Goodacre-Querengesser/garbox/garbox.kicad_pcb

## KiCad design garbox.kicad_pcb (2025-11-29)

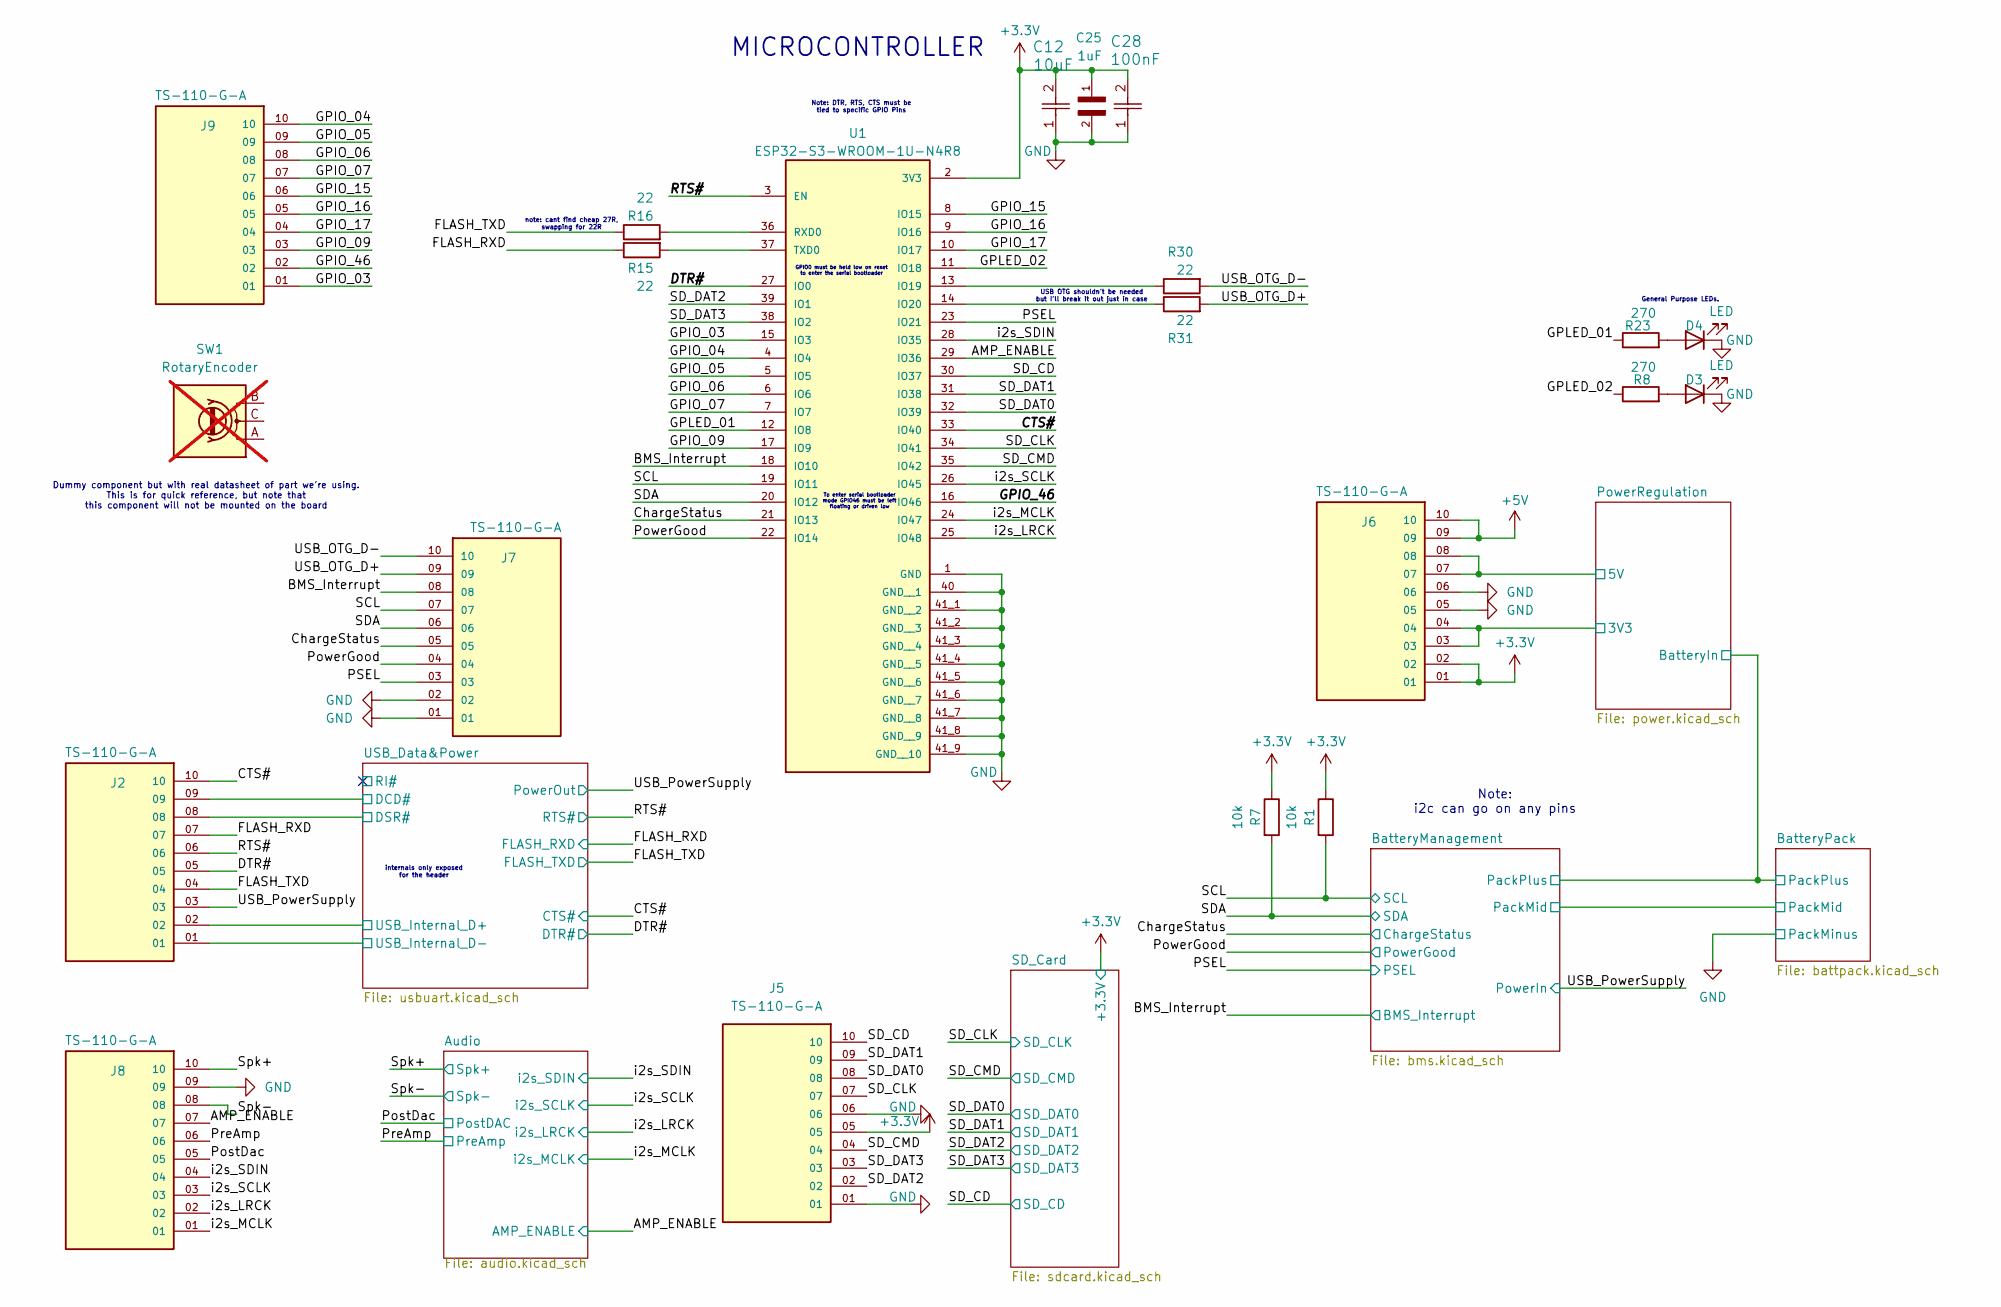
[picture p1: schematic garbox.kicad_sch]

Parts:
C12: 10uF; CAP_CL31_SAM; MPN C13585
C25: 1uF; CAPC3216X180N; MPN C1848
C28: 100nF; CAPC1005X55N; MPN C1525
D3, D4: LED; LED_0201_0603Metric; MPN C2286
J2, J5, J6, J7, J8, J9: TS-110-G-A; SAMTEC_TS-110-G-A; PARTREV R
R1, R7: 10k; R_0201_0603Metric; MPN C25804
R8, R23: 270; R_0201_0603Metric; MPN C22966
R15, R16, R30, R31: 22; R_0201_0603Metric; MPN C23345
SW1: RotaryEncoder; RotaryEncoder_Bourns_Horizontal_PEC09-2xxxF-Nxxxx; MPN C143788; not fitted
U1: ESP32-S3-WROOM-1U-N4R8; XCVR_ESP32-S3-WROOM-1U-N4R8; PARTREV v1.1

Connections:
+3.3V: C12.2, C25.1, C28.2, J5.05, J6.01, J6.02, R1.1, R7.1, U1.2 (3V3); also elsewhere on the board
+5V: J6.09, J6.10; also elsewhere on the board
/AMP_ENABLE: J8.07, U1.29 (IO36); also elsewhere on the board
/BMS_Interrupt: J7.08, U1.18 (IO10); also elsewhere on the board
/CTS#: J2.10, U1.33 (IO40); also elsewhere on the board
/ChargeStatus: J7.05, U1.21 (IO13); also elsewhere on the board
/DTR#: J2.05, U1.27 (IO0); also elsewhere on the board
/FLASH_RXD: J2.07, R15.1; also elsewhere on the board
/FLASH_TXD: J2.04, R16.1; also elsewhere on the board
/GPIO_03: J9.01, U1.15 (IO3)
/GPIO_04: J9.10, U1.4 (IO4)
/GPIO_05: J9.09, U1.5 (IO5)
/GPIO_06: J9.08, U1.6 (IO6)
/GPIO_07: J9.07, U1.7 (IO7)
/GPIO_09: J9.03, U1.17 (IO9)
/GPIO_15: J9.06, U1.8 (IO15)
/GPIO_16: J9.05, U1.9 (IO16)
/GPIO_17: J9.04, U1.10 (IO17)
/GPIO_46: J9.02, U1.16 (IO46)
/GPLED_01: R23.1, U1.12 (IO8)
/GPLED_02: R8.1, U1.11 (IO18)
/PSEL: J7.03, U1.23 (IO21); also elsewhere on the board
/PostDac: J8.05; also elsewhere on the board
/PowerGood: J7.04, U1.22 (IO14); also elsewhere on the board
/PowerRegulation/3V3: J6.03, J6.04; also elsewhere on the board
/PowerRegulation/5V: J6.07, J6.08; also elsewhere on the board
/PreAmp: J8.06; also elsewhere on the board
/RTS#: J2.06, U1.3 (EN); also elsewhere on the board
/SCL: J7.07, R1.2, U1.19 (IO11); also elsewhere on the board
/SDA: J7.06, R7.2, U1.20 (IO12); also elsewhere on the board
/SD_CD: J5.10, U1.30 (IO37); also elsewhere on the board
/SD_CLK: J5.07, U1.34 (IO41); also elsewhere on the board
/SD_CMD: J5.04, U1.35 (IO42); also elsewhere on the board
/SD_DAT0: J5.08, U1.32 (IO39); also elsewhere on the board
/SD_DAT1: J5.09, U1.31 (IO38); also elsewhere on the board
/SD_DAT2: J5.02, U1.39 (IO1); also elsewhere on the board
/SD_DAT3: J5.03, U1.38 (IO2); also elsewhere on the board
/Spk+: J8.10; also elsewhere on the board
/Spk-: J8.08; also elsewhere on the board
/USB_Data&Power/DCD#: J2.09; also elsewhere on the board
/USB_Data&Power/DSR#: J2.08; also elsewhere on the board
/USB_Data&Power/USB_D+: J2.02; also elsewhere on the board
/USB_Data&Power/USB_D-: J2.01; also elsewhere on the board
/USB_OTG_D+: J7.09, R31.2
/USB_OTG_D-: J7.10, R30.2
/USB_PowerSupply: J2.03; also elsewhere on the board
/i2s_LRCK: J8.02, U1.25 (IO48); also elsewhere on the board
/i2s_MCLK: J8.01, U1.24 (IO47); also elsewhere on the board
/i2s_SCLK: J8.03, U1.26 (IO45); also elsewhere on the board
/i2s_SDIN: J8.04, U1.28 (IO35); also elsewhere on the board
GND: C12.1, C25.2, C28.1, D3.1 (K), D4.1 (K), J5.01, J5.06, J6.05, J6.06, J7.01, J7.02, J8.09, U1.1 (GND), U1.40 (GND__1), U1.41_1 (GND__2), U1.41_2 (GND__3), U1.41_3 (GND__4), U1.41_4 (GND__5), U1.41_5 (GND__6), U1.41_6 (GND__7), U1.41_7 (GND__8), U1.41_8 (GND__9), U1.41_9 (GND__10), U1.41_10, U1.41_11, U1.41_12, U1.41_13, U1.41_14, U1.41_15, U1.41_16, U1.41_17, U1.41_18, U1.41_19, U1.41_20, U1.41_21; also elsewhere on the board
unnamed: D3.2 (A), R8.2
unnamed: D4.2 (A), R23.2
unnamed: R30.1, U1.13 (IO19)
unnamed: R31.1, U1.14 (IO20)
unnamed: R16.2, U1.36 (RXD0)
unnamed: R15.2, U1.37 (TXD0)

Notes on the sheet:
GPIO0 must be held low on reset to enter the serial bootloader
Note: DTR, RTS, CTS must be tied to specific GPIO Pins
internals only exposed for the header
note: cant find cheap 27R, swapping for 22R
Dummy component but with real datasheet of part we're using. This is for quick reference, but note that this component will not be mounted on the board
MICROCONTROLLER
Note: i2c can go on any pins
To enter serial bootloader mode GPIO46 must be left floating or driven low
USB OTG shouldn't be needed but I'll break it out just in case
General Purpose LEDs.

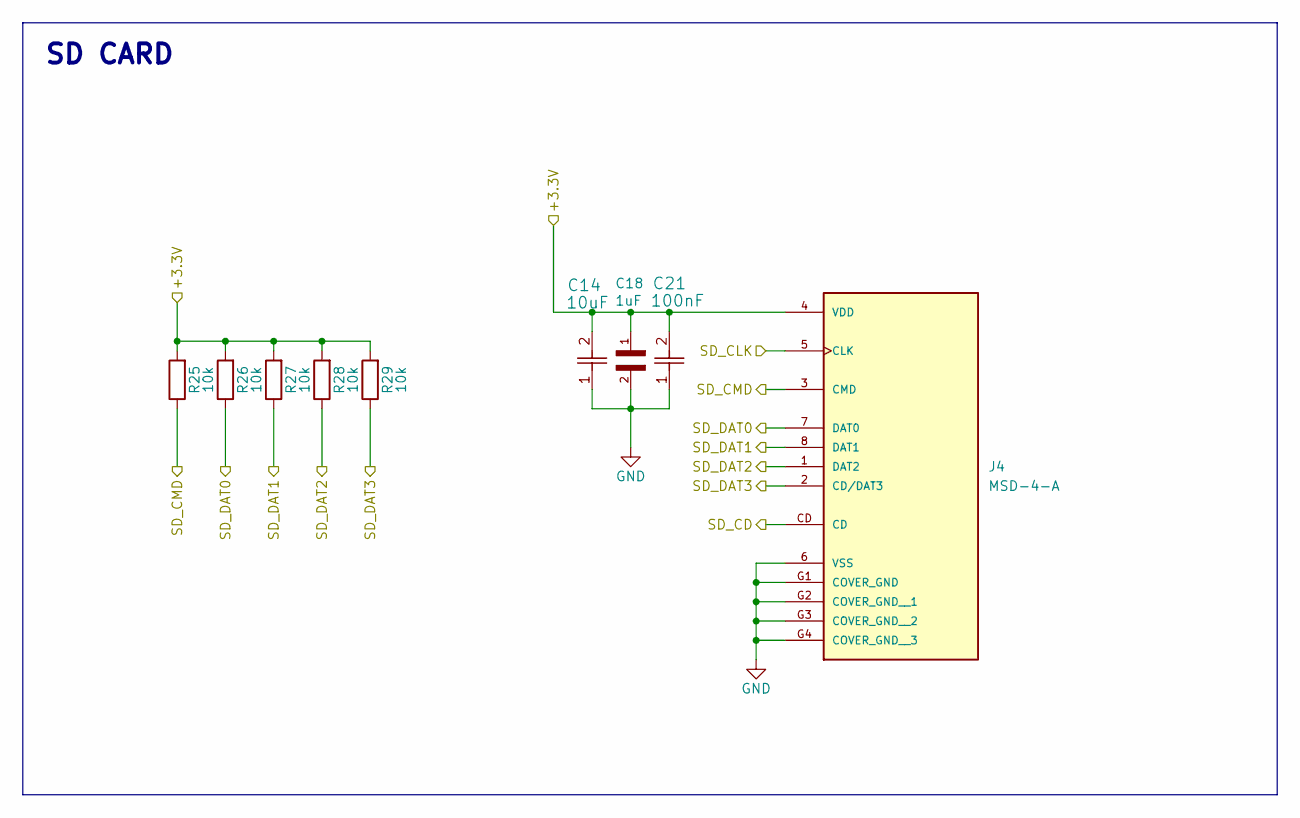
[picture p2: schematic sdcard.kicad_sch]

Parts:
C14: 10uF; CAP_CL31_SAM; MPN C13585
C18: 1uF; CAPC3216X180N; MPN C1848
C21: 100nF; CAPC1005X55N; MPN C1525
J4: MSD-4-A; CUI_MSD-4-A; PARTREV 1.0
R25, R26, R27, R28, R29: 10k; R_0201_0603Metric; MPN C25804

Connections:
+3.3V: C14.2, C18.1, C21.2, J4.4 (VDD), R25.2, R26.2, R27.2, R28.2, R29.2; also elsewhere on the board
/SD_CD: J4.CD; also elsewhere on the board
/SD_CLK: J4.5 (CLK); also elsewhere on the board
/SD_CMD: J4.3 (CMD), R25.1; also elsewhere on the board
/SD_DAT0: J4.7 (DAT0), R26.1; also elsewhere on the board
/SD_DAT1: J4.8 (DAT1), R27.1; also elsewhere on the board
/SD_DAT2: J4.1 (DAT2), R28.1; also elsewhere on the board
/SD_DAT3: J4.2 (CD/DAT3), R29.1; also elsewhere on the board
GND: C14.1, C18.2, C21.1, J4.6 (VSS), J4.G1 (COVER_GND), J4.G2 (COVER_GND__1), J4.G3 (COVER_GND__2), J4.G4 (COVER_GND__3); also elsewhere on the board

Notes on the sheet:
SD CARD

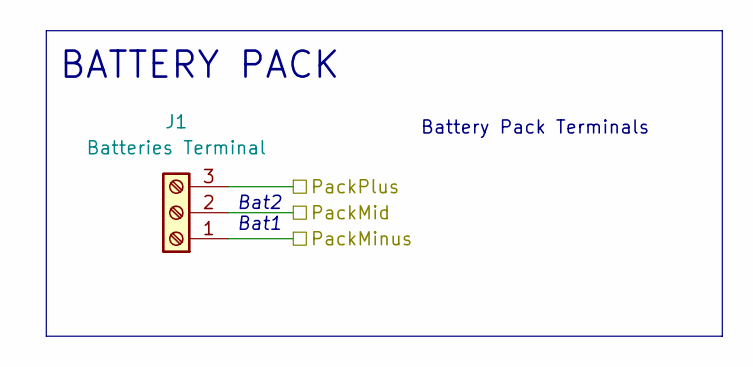
[picture p3: schematic battpack.kicad_sch, GarBox]

Parts:
J1: Batteries Terminal; TerminalBlock_bornier-3_P5.08mm

Connections:
/BatteryManagement/PackMid: J1.2; also elsewhere on the board
/BatteryManagement/PackPlus: J1.3; also elsewhere on the board
GND: J1.1; also elsewhere on the board

Notes on the sheet:
Battery Pack Terminals
BATTERY PACK
Bat2 Bat1

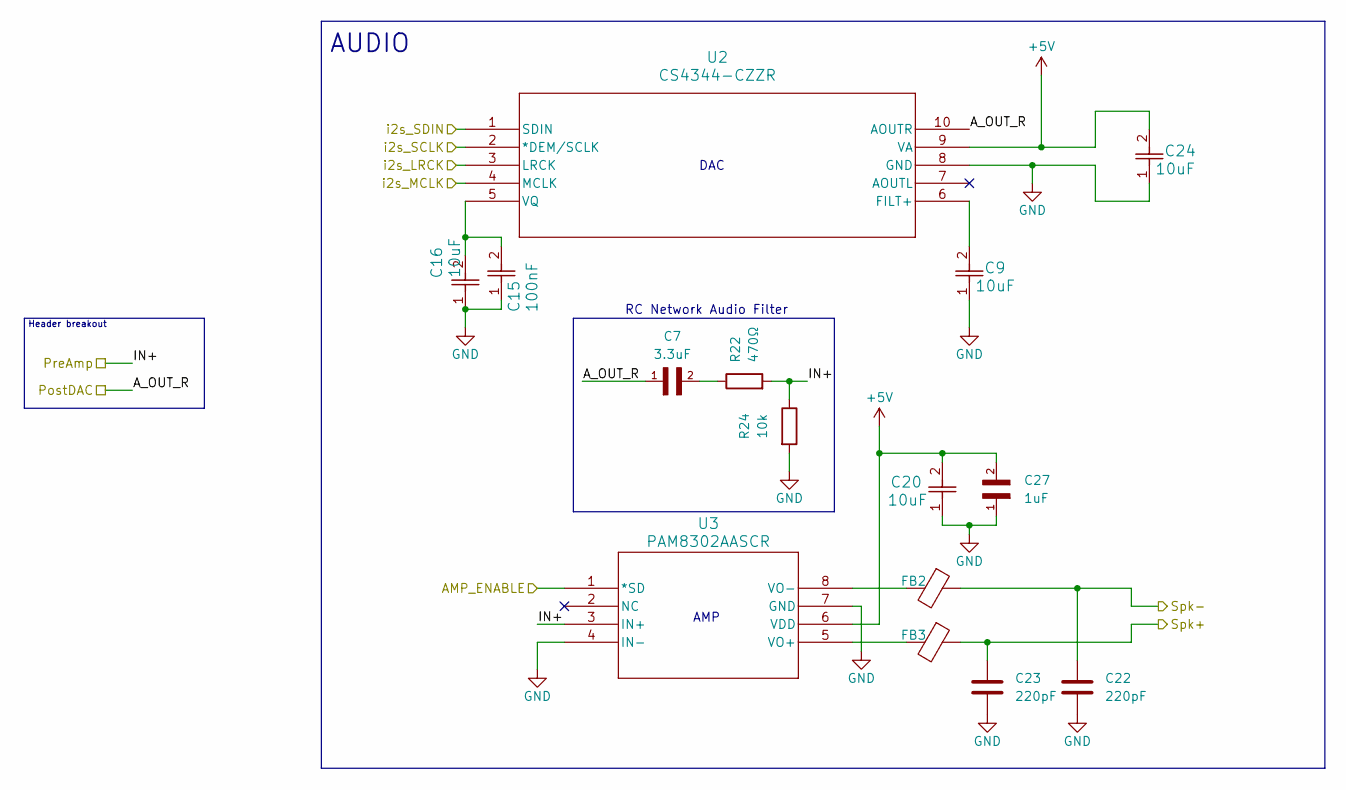
[picture p4: schematic audio.kicad_sch, GarBox]

Parts:
C7: 3.3uF; CAPC1608X90N; MPN C51412
C9, C16, C20, C24: 10uF; CAP_CL31_SAM; MPN C13585
C15: 100nF; CAPC1005X55N; MPN C1525
C22, C23: 220pF; C_0201_0603Metric; MPN C1603
C27: 1uF; CAPC3216X180N; MPN C1848
FB2, FB3: GZ1608D601TF; L_Sunlord_MWSA0603S; MPN C1002
R22: 470Ω; R_0603_1608Metric; MPN C23179
R24: 10k; R_0201_0603Metric; MPN C25804
U2: CS4344-CZZR; CIR_3TSSOP-10; MPN C2895053
U3: PAM8302AASCR; PAM8302AASCR_DIO; MPN C113367

Connections:
+5V: C20.2, C24.2, C27.2, U2.9 (VA), U3.6 (VDD); also elsewhere on the board
/AMP_ENABLE: U3.1 (*SD); also elsewhere on the board
/PostDac: C7.1, U2.10 (AOUTR); also elsewhere on the board
/PreAmp: R22.2, R24.1, U3.3 (IN+); also elsewhere on the board
/Spk+: C23.1, FB3.1; also elsewhere on the board
/Spk-: C22.1, FB2.1; also elsewhere on the board
/i2s_LRCK: U2.3 (LRCK); also elsewhere on the board
/i2s_MCLK: U2.4 (MCLK); also elsewhere on the board
/i2s_SCLK: U2.2 (*DEM/SCLK); also elsewhere on the board
/i2s_SDIN: U2.1 (SDIN); also elsewhere on the board
GND: C9.1, C15.1, C16.1, C20.1, C22.2, C23.2, C24.1, C27.1, R24.2, U2.8 (GND), U3.4 (IN-), U3.7 (GND); also elsewhere on the board
unnamed: C7.2, R22.1
unnamed: C9.2, U2.6 (FILT+)
unnamed: C15.2, C16.2, U2.5 (VQ)
unnamed: FB3.2, U3.5 (VO+)
unnamed: FB2.2, U3.8 (VO-)

Notes on the sheet:
AUDIO
Header breakout
AMP
DAC
RC Network Audio Filter

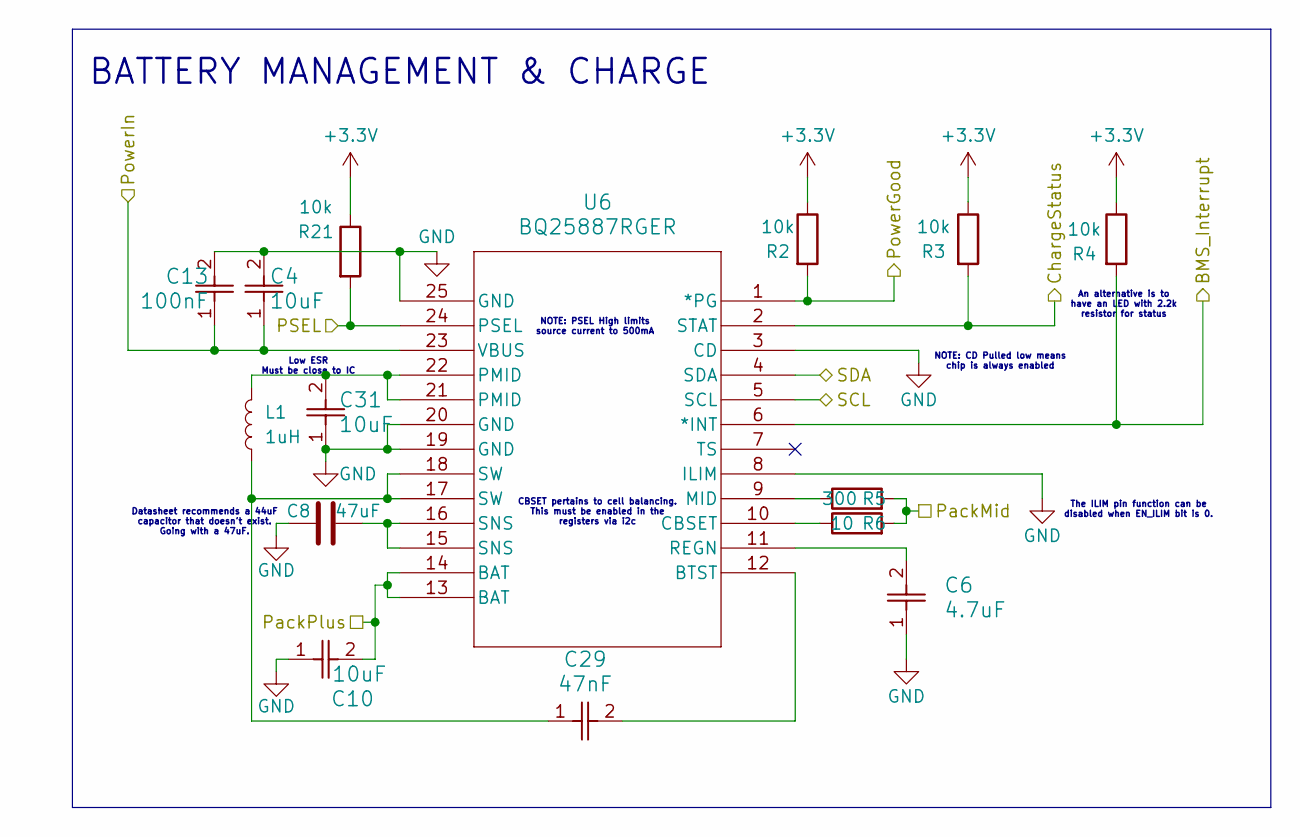
[picture p5: schematic bms.kicad_sch, GarBox]

Parts:
C4, C31: 10uF; CAP_CL21_SAM; MPN C15850
C6: 4.7uF; C_0805_2012Metric; MPN C1779
C8: 47uF; C_1206_3216Metric; MPN C96123
C10: 10uF; CAP_CL31_SAM; MPN C13585
C13: 100nF; CAPC1005X55N; MPN C1525
C29: 47nF; CAP_CL10_SAM; MPN C1622
L1: 1uH; L_Wuerth_WE-GF-1210; MPN C439775
R2, R3, R4, R21: 10k; R_0201_0603Metric; MPN C25804
R5: 300; R_0201_0603Metric; MPN C23025
R6: 10; R_2512_6332Metric; MPN C16861
U6: BQ25887RGER; VQFN24_RGE_TEX; MPN C2761614

Connections:
+3.3V: R2.1, R3.1, R4.1, R21.1; also elsewhere on the board
/BMS_Interrupt: R4.2, U6.6 (*INT); also elsewhere on the board
/BatteryManagement/PackMid: R5.2, R6.2; also elsewhere on the board
/BatteryManagement/PackPlus: C10.2, U6.13 (BAT), U6.14 (BAT); also elsewhere on the board
/ChargeStatus: R3.2, U6.2 (STAT); also elsewhere on the board
/PSEL: R21.2, U6.24 (PSEL); also elsewhere on the board
/PowerGood: R2.2, U6.1 (*PG); also elsewhere on the board
/SCL: U6.5 (SCL); also elsewhere on the board
/SDA: U6.4 (SDA); also elsewhere on the board
/USB_PowerSupply: C4.1, C13.1, U6.23 (VBUS); also elsewhere on the board
GND: C4.2, C6.1, C8.2, C10.1, C13.2, C31.1, U6.3 (CD), U6.8 (ILIM), U6.19 (GND), U6.20 (GND), U6.25 (GND); also elsewhere on the board
unnamed: C8.1, U6.15 (SNS), U6.16 (SNS)
unnamed: C29.1, L1.1, U6.17 (SW), U6.18 (SW)
unnamed: C31.2, L1.2, U6.21 (PMID), U6.22 (PMID)
unnamed: C29.2, U6.12 (BTST)
unnamed: R6.1, U6.10 (CBSET)
unnamed: R5.1, U6.9 (MID)
unnamed: C6.2, U6.11 (REGN)

Notes on the sheet:
BATTERY MANAGEMENT & CHARGE
NOTE: CD Pulled low means chip is always enabled
CBSET pertains to cell balancing. This must be enabled in the registers via i2c
Datasheet recommends a 44uF capacitor that doesn't exist. Going with a 47uF.
NOTE: PSEL High limits source current to 500mA
Low ESR Must be close to IC
An alternative is to have an LED with 2.2k resistor for status
The ILIM pin function can be disabled when EN_ILIM bit is 0.

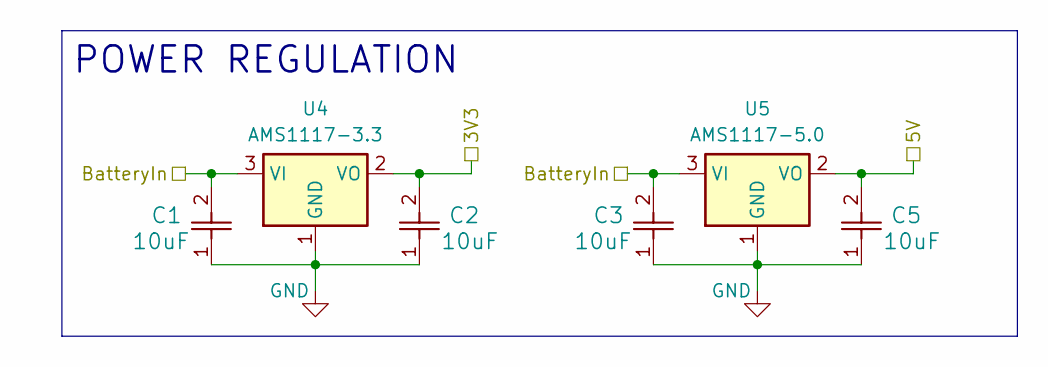
[picture p6: schematic power.kicad_sch, GarBox]

Parts:
C1, C2, C3, C5: 10uF; CAP_CL31_SAM; MPN C13585
U4: AMS1117-3.3; SOT-223-3_TabPin2; MPN C6186
U5: AMS1117-5.0; SOT-223-3_TabPin2; MPN C6187

Connections:
/BatteryManagement/PackPlus: C1.2, C3.2, U4.3 (VI), U5.3 (VI); also elsewhere on the board
/PowerRegulation/3V3: C2.2, U4.2 (VO); also elsewhere on the board
/PowerRegulation/5V: C5.2, U5.2 (VO); also elsewhere on the board
GND: C1.1, C2.1, C3.1, C5.1, U4.1 (GND), U5.1 (GND); also elsewhere on the board

Notes on the sheet:
POWER REGULATION

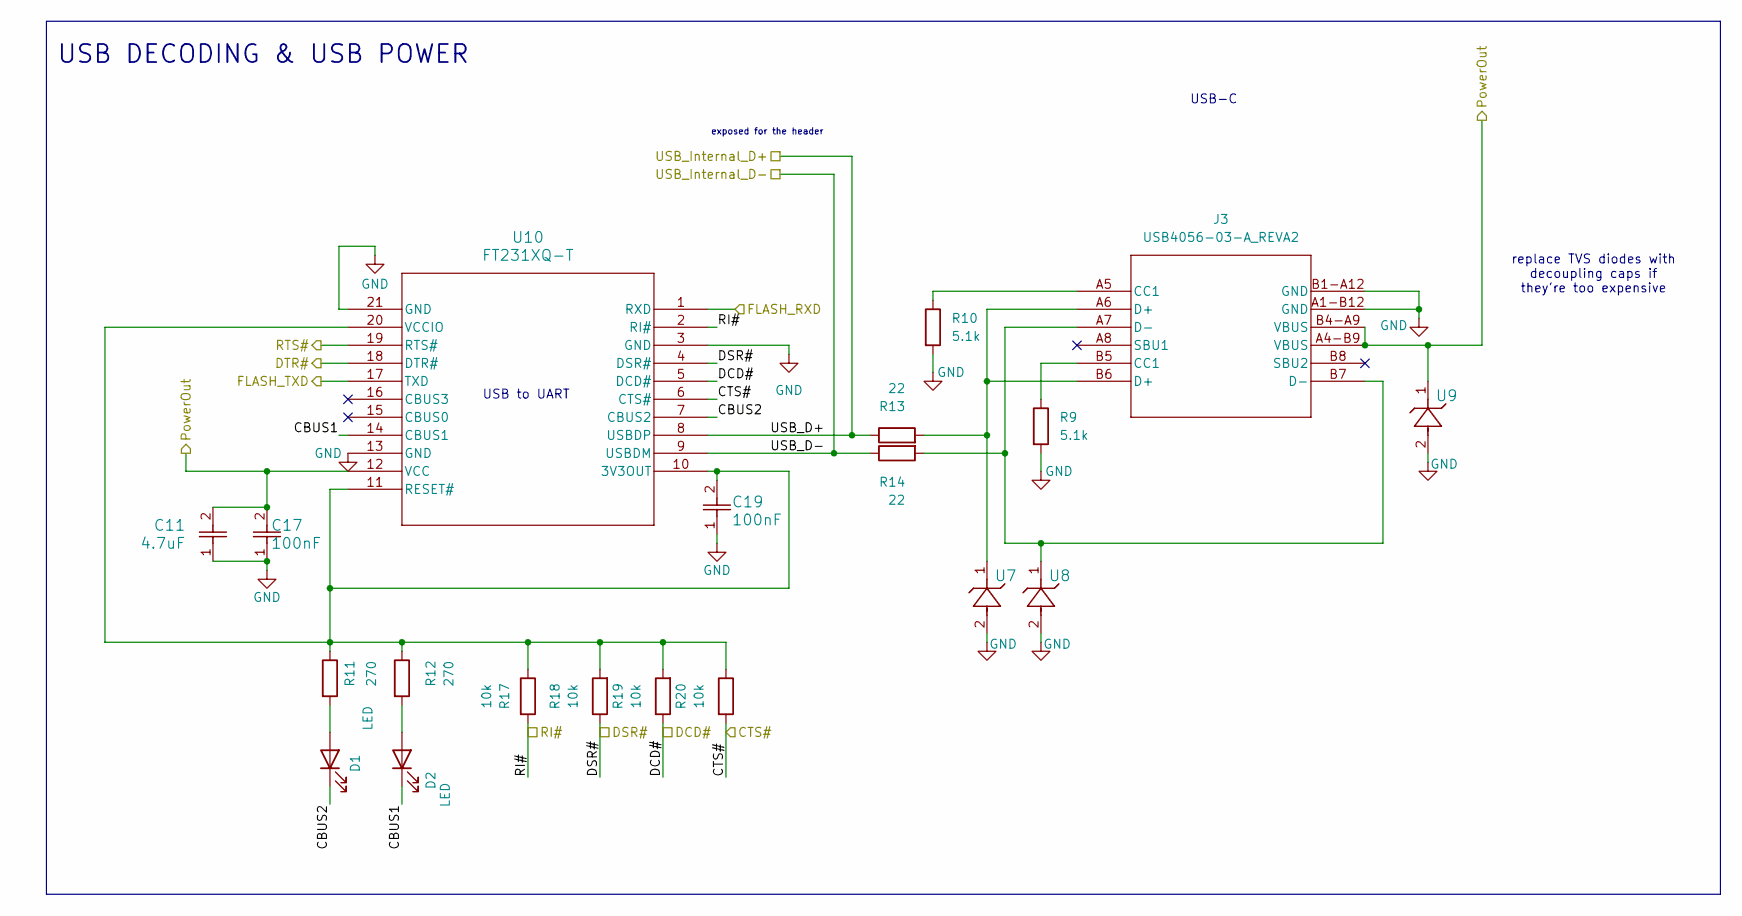
[picture p7: schematic usbuart.kicad_sch, GarBox]

Parts:
C11: 4.7uF; C_0805_2012Metric; MPN C1779
C17, C19: 100nF; CAPC1005X55N; MPN C1525
D1, D2: LED; LED_0201_0603Metric; MPN C2286
J3: USB4056-03-A_REVA2; 12402012E212A_AMP; PARTREV A2
R9, R10: 5.1k; R_0201_0603Metric; MPN C23186
R11, R12: 270; R_0201_0603Metric; MPN C22966
R13, R14: 22; R_0201_0603Metric; MPN C23345
R17, R18, R19, R20: 10k; R_0201_0603Metric; MPN C25804
U7, U8, U9: CPDQ5V0-HF; CPDQ; MPN C2441615
U10: FT231XQ-T; QFN20_FT231XQ_FTD; MPN C1521552

Connections:
/CTS#: R20.2, U10.6 (CTS#); also elsewhere on the board
/DTR#: U10.18 (DTR#); also elsewhere on the board
/FLASH_RXD: U10.1 (RXD); also elsewhere on the board
/FLASH_TXD: U10.17 (TXD); also elsewhere on the board
/RTS#: U10.19 (RTS#); also elsewhere on the board
/USB_Data&Power/CBUS1: D2.1 (K), U10.14 (CBUS1)
/USB_Data&Power/CBUS2: D1.1 (K), U10.7 (CBUS2)
/USB_Data&Power/DCD#: R19.1, U10.5 (DCD#); also elsewhere on the board
/USB_Data&Power/DSR#: R18.1, U10.4 (DSR#); also elsewhere on the board
/USB_Data&Power/RI#: R17.2, U10.2 (RI#)
/USB_Data&Power/USB_D+: R13.1, U10.8 (USBDP); also elsewhere on the board
/USB_Data&Power/USB_D-: R14.1, U10.9 (USBDM); also elsewhere on the board
/USB_PowerSupply: C11.2, C17.2, J3.A4-B9 (VBUS), J3.B4-A9 (VBUS), U9.1, U10.12 (VCC); also elsewhere on the board
GND: C11.1, C17.1, C19.1, J3.A1-B12 (GND), J3.B1-A12 (GND), R9.2, R10.2, U7.2, U8.2, U9.2, U10.3 (GND), U10.13 (GND), U10.21 (GND); also elsewhere on the board
unnamed: D1.2 (A), R11.2
unnamed: D2.2 (A), R12.2
unnamed: J3.A5 (CC1), R10.1
unnamed: J3.B5 (CC1), R9.1
unnamed: J3.A6 (D+), J3.B6 (D+), R13.2, U7.1
unnamed: J3.A7 (D-), J3.B7 (D-), R14.2, U8.1
unnamed: C19.2, R11.1, R12.1, R17.1, R18.2, R19.2, R20.1, U10.10 (3V3OUT), U10.11 (RESET#), U10.20 (VCCIO)

Notes on the sheet:
replace TVS diodes with decoupling caps if they're too expensive
exposed for the header
USB to UART
USB-C
USB DECODING & USB POWER

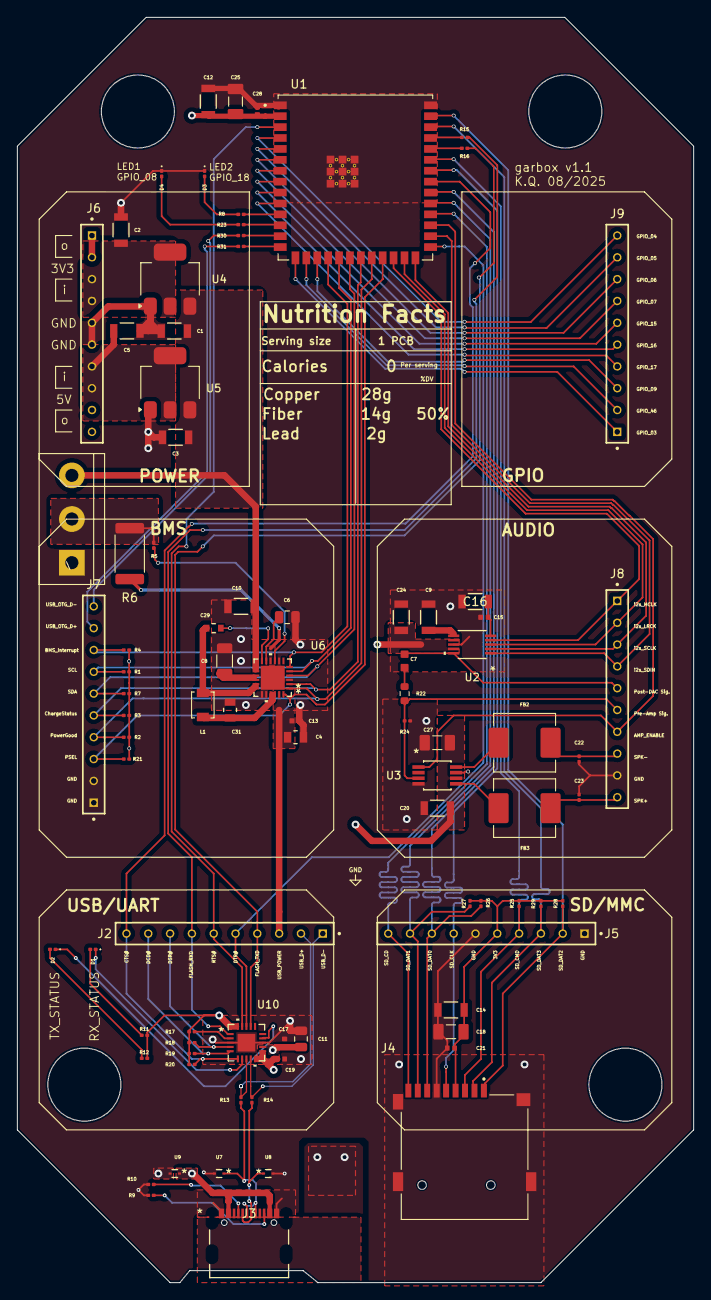
[picture p8: board garbox.kicad_pcb from above]

Board: 4 copper layers, 78.7 x 147.3 mm, 86 parts (0 on the bottom side), 81 nets.
