Goodacre-Querengesser/garbox/(commit log)

2025-08-22 added headers, cleaned up main schematic and now replanning board layout
2025-08-22 meant to put these in the last commit
    [garbox.kicad_pcb, garbox.kicad_sch, sdcard.kicad_sch, usbuart.kicad_sch]
2025-08-23 Finished preliminary routing of v1.1 of the board
    [audio.kicad_sch, garbox.kicad_pcb, garbox.kicad_sch]
2025-08-23 Cleaned up silkscreen and finished routing
    [garbox.kicad_pcb]
2025-08-27 fixed incorrect gpio and added silkscreen funny
    [garbox.kicad_pcb, garbox.kicad_sch]
2025-08-27 assigned 3d models to footprints
    [garbox.kicad_pcb]
2025-08-27 fixed usb clearance, added ground plane to top and bottom
    [garbox.kicad_pcb]
2025-10-17 designated MPN parts from JLC library
    [audio.kicad_sch, battpack.kicad_sch, bms.kicad_sch, garbox.kicad_pcb, garbox.kicad_sch, power.kicad_sch, sdcard.kicad_sch, usbuart.kicad_sch]
2025-11-14 Updated part numbers
    [audio.kicad_sch, battpack.kicad_sch, bms.kicad_sch, garbox.kicad_pcb, garbox.kicad_sch, power.kicad_sch, sdcard.kicad_sch, usbuart.kicad_sch]
2025-11-28 swapped esp32-s3-wroom-1-n4r8 for esp32-s3-wroom-1u-n4r8 board, fixed unconnected net on USB connector, and tidied up some traces on usb.
    [garbox.kicad_pcb, garbox.kicad_sch]
2025-11-29 changed minimum hole/diameter size to 0.2mm/0.45mm for manufacturer compliance. moved some traces around to avoid DRC errors accordingly
    [garbox.kicad_pcb]
